eziosoft/weatherEpaperDisplay/files/IMG_20200730_230357.jpg

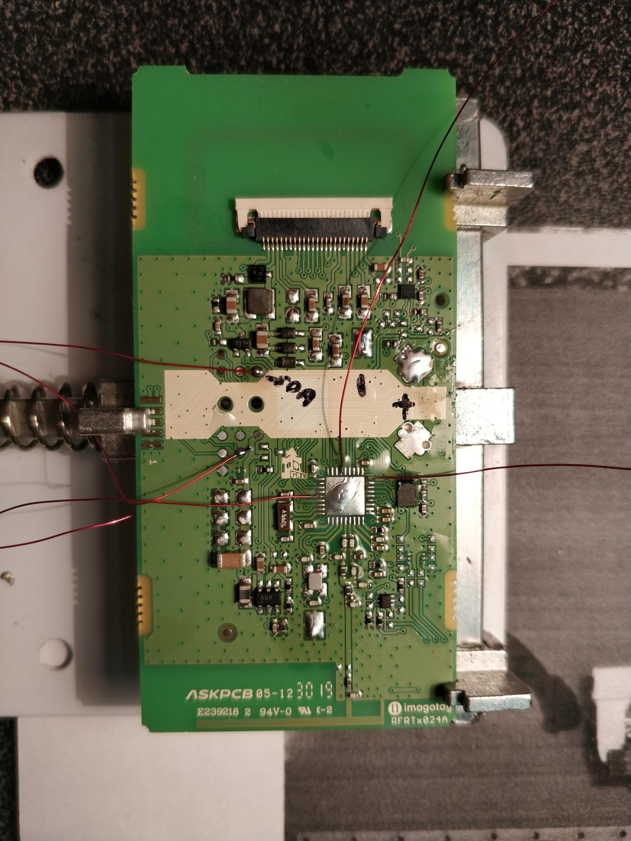
files/IMG_20200730_230357.jpg
