eziosoft/weatherEpaperDisplay/files/IMG_20200831_213312.jpg

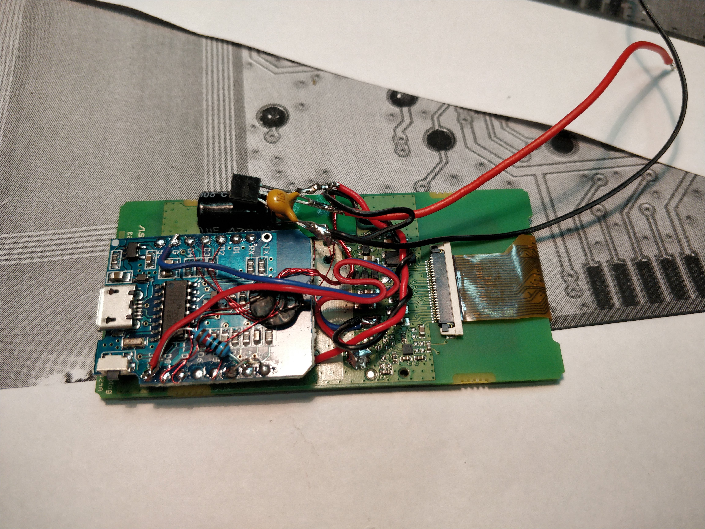
files/IMG_20200831_213312.jpg
