eziosoft/weatherEpaperDisplay/files/IMG_20200831_213321.jpg

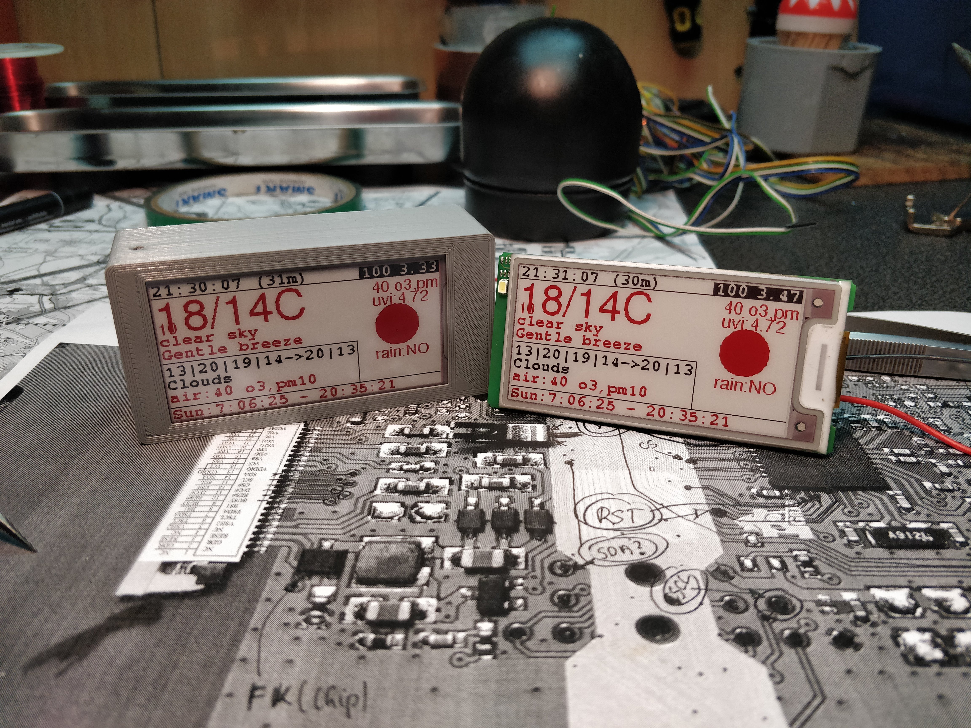
files/IMG_20200831_213321.jpg
