eziosoft/weatherEpaperDisplay/(commit log)

2020-06-28 Fixed dead lock when MQTT is not available
    [e_paper_logo.ino, wifi.ino]
2020-07-23 firmware update from http - not tested, added voltage offset
2020-07-29 json telemtry bug fix
    [e_paper_logo.ino, wifi.ino]
2020-07-31 ID added, telemetry bug report
    [e_paper_logo.ino, wifi.ino]
2020-07-31 prevent timeout reboot during firmware update
    [e_paper_logo.ino]
2020-07-31 telemetry json bug fixed
    [e_paper_logo.ino, wifi.ino]
2020-09-15 deep sleep delay when error 10min
    [e_paper_logo.ino, wifi.ino]
